nicotakuya/diyfcpaddle/diy_fc_paddle_schematics.png

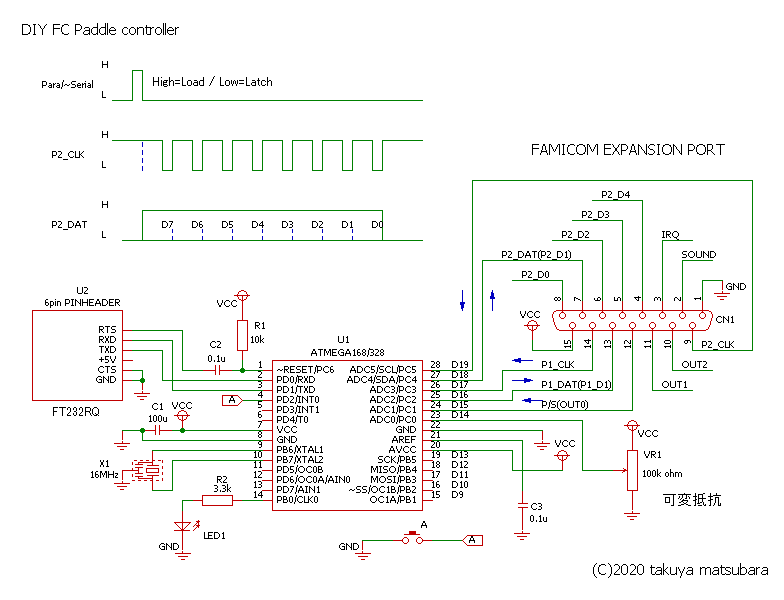
diy_fc_paddle_schematics.png
